PingguSoft/esp32_s3_openfire/stl/button_plate.stl

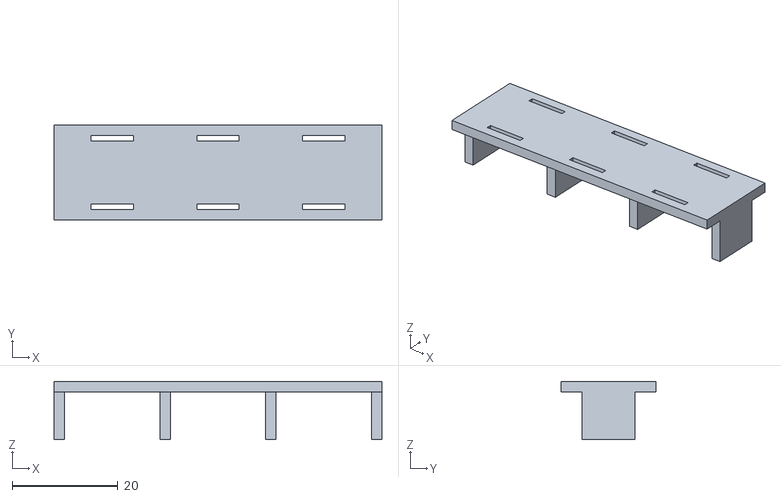
[picture p3: CAD file, 2024-09-30]
stl/button_plate.stl
62.0 x 18.0 x 11.0
