PingguSoft/esp32_s3_openfire/stl/pspjoystick_plate.3mf

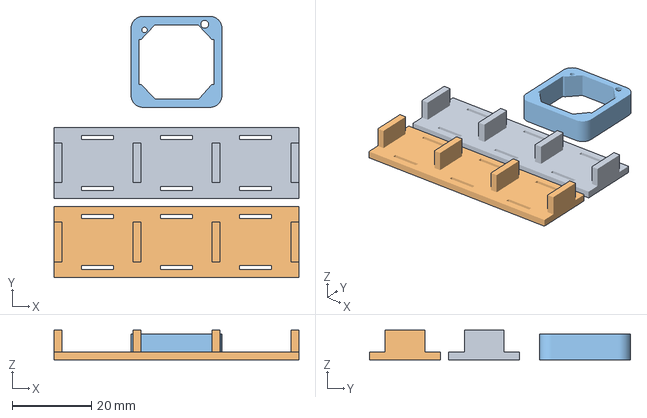
[picture p4: CAD file, 2024-09-30]
stl/pspjoystick_plate.3mf
62.0 x 66.1 x 7.50 mm
button_plate.stl x 2
pspjoystick_plate.stl
