PingguSoft/esp32_s3_openfire/stl/trigger_switch_board.stl

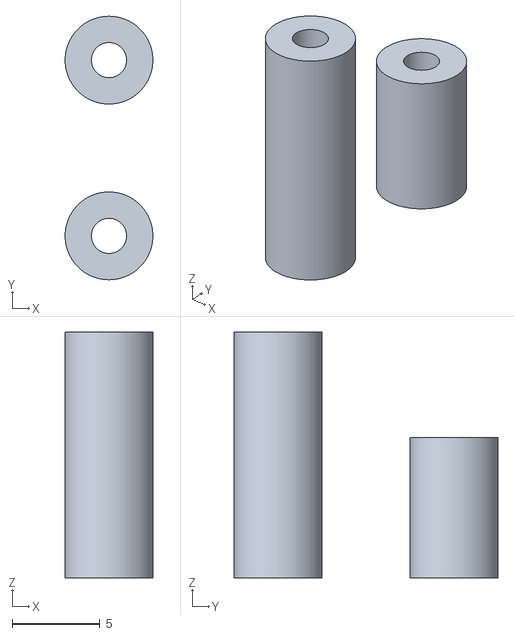
[picture p5: CAD file, 2024-08-26]
stl/trigger_switch_board.stl
5.00 x 15.0 x 14.0
