PingguSoft/esp32_s3_openfire/stl/pwr_board.stl

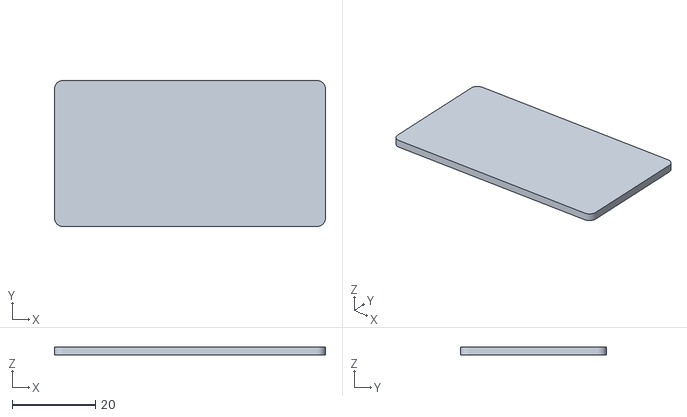
[picture p6: CAD file, 2024-08-26]
stl/pwr_board.stl
65.0 x 35.0 x 2.00
