PingguSoft/esp32_s3_openfire/stl/recoil_relay_adapter.stl

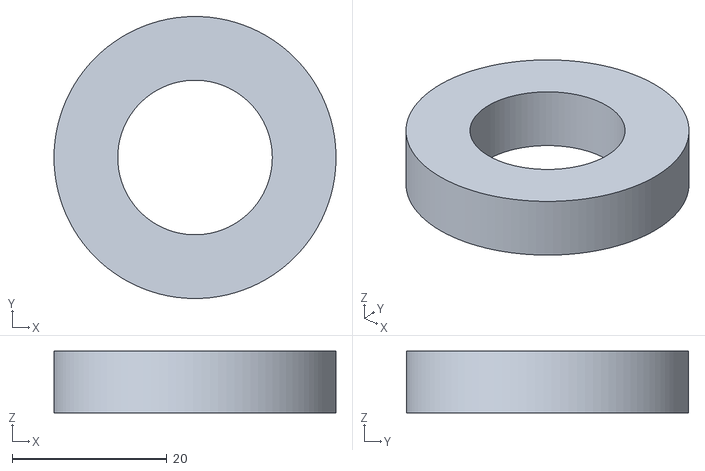
[picture p7: CAD file, 2024-08-21]
stl/recoil_relay_adapter.stl
36.5 x 36.5 x 8.00
