PingguSoft/esp32_s3_openfire/stl/lens_holder.stl

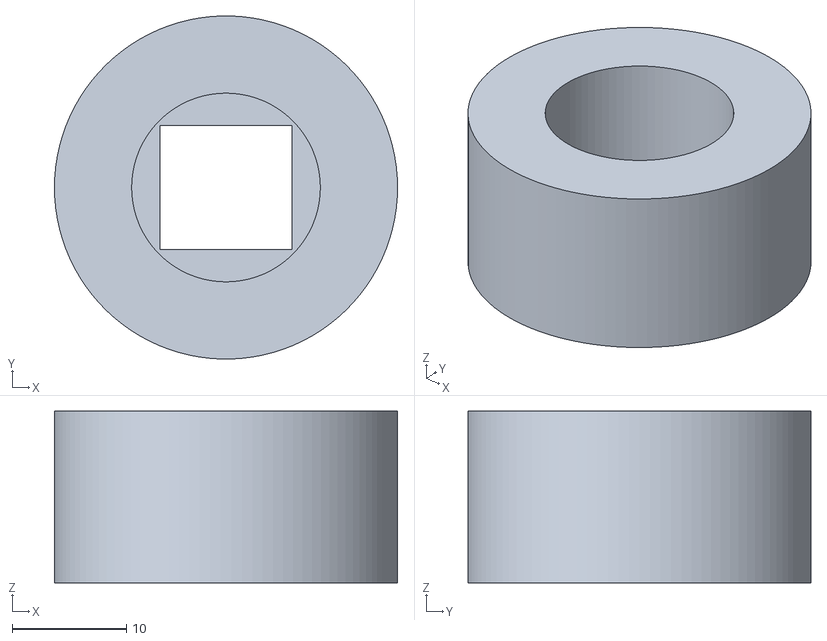
[picture p8: CAD file, 2024-08-21]
stl/lens_holder.stl
30.0 x 30.0 x 15.0
