PingguSoft/esp32_s3_openfire/(list of files, cad)

Other CAD files:
stl/pspjoystick_plate.stl
