PingguSoft/esp32_s3_openfire/docs/tool_issues.txt

.platformio\penv\Lib\site-packages\platformio\util.py 수정 for arm64
arm64 package가 대부분 없으므로 amd64용으로 받기위함

def get_systype():
    system = platform.system().lower()
    arch = platform.machine().lower()
    if system == "windows":
        if not arch:  # issue #4353
            arch = "x86_" + platform.architecture()[0]
        if "x86" in arch:
            arch = "amd64" if "64" in arch else "x86"
        if "arm64" in arch:
            arch = "amd64"

    if arch == "aarch64" and platform.architecture()[0] == "32bit":
        arch = "armv7l"
    return "%s_%s" % (system, arch) if arch else system

esp32s3 usb down 로드 후 reset 안되는 문제

C:\Users\krperf\.platformio\packages\tool-esptoolpy\esptool\targets\esp32s3.py
    def hard_reset(self):
        uses_usb_otg = self.uses_usb_otg()
        if uses_usb_otg:
            self._check_if_can_reset()

        try:
            # Clear force download boot mode to avoid the chip being stuck in download mode after reset
            # workaround for issue: https://github.com/espressif/arduino-esp32/issues/6762
            self.write_reg(
                self.RTC_CNTL_OPTION1_REG, 0, self.RTC_CNTL_FORCE_DOWNLOAD_BOOT_MASK
            )
        except Exception:
            # Skip if response was not valid and proceed to reset; e.g. when monitoring while resetting
            pass

        print("Hard resetting via RTS pin...")
        HardReset(self._port, uses_usb_otg)()

reset !!!
pio run -t reset_target --upload-port COM4
