PingguSoft/esp32_s3_openfire/codes/src/SamcoDisplay.h

/*!
 * @file SamcoDisplay.h
 * @brief Macros for lightgun HUD display.
 *
 * @copyright That One Seong, 2024
 *
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
 *  You should have received a copy of the GNU General Public License
 *  along with this program.  If not, see <https://www.gnu.org/licenses/>.
 */

#ifndef _SAMCODISPLAY_H_
#define _SAMCODISPLAY_H_

#include <stdint.h>

#define SCREEN_WIDTH 128
#define SCREEN_HEIGHT 64

class ExtDisplay {
public:
    /// @brief Constructor
    ExtDisplay();

    /// @brief Attempt to start display using current pin numbers from SamcoPreferences
    /// @return success (true) or fail (false)
    bool Begin();

    /// @brief Update top panel with new info
    /// @return nothing
    void TopPanelUpdate(char textPrefix[7], char textInput[16]);

    /// @brief Clear screen for different gun modes
    /// @return nothing
    void ScreenModeChange(int8_t screenMode, bool isAnalog = false);

    /// @brief Perform maintenance operations (WIP)
    /// @details For when values aren't being updated, but still want to change something on the screen
    /// (i.e. small text printouts when health/ammo empty)
    /// @return nothing
    void IdleOps();

    /// @brief Draw seen points here
    /// @details Should ONLY be used in scenarios where the mouse isn't being updated, i.e. calibration.
    /// @return nothing
    void DrawVisibleIR(int pointX[4], int pointY[4]);

    /// @brief Draw hotkey pause mode layout
    /// @return nothing
    void PauseScreenShow(uint8_t currentProf, char name1[16], char name2[16], char name3[16], char name4[16]);

    /// @brief Update simple pause mode list on screen
    /// @return nothing
    void PauseListUpdate(uint8_t selection);

    /// @brief Update simple pause mode profiles list on screen
    /// @return nothing
    void PauseProfileUpdate(uint8_t selection, char name1[16], char name2[16], char name3[16], char name4[16]);

    /// @brief Print save status message
    void SaveScreen(uint8_t status);

    /// @brief Update main screen ammo glyphs
    /// @return nothing
    void PrintAmmo(uint8_t ammo);

    /// @brief Update main screen life glyphs
    /// @return nothing
    void PrintLife(uint8_t life);

    enum ScreenMode_e {
        Screen_None = -1,
        Screen_Init = 0,
        Screen_Normal,
        Screen_Pause,
        Screen_Profile,
        Screen_Saving,
        Screen_SaveSuccess,
        Screen_SaveError,
        Screen_Calibrating,
        Screen_IRTest,
        Screen_Docked,
        Screen_Mamehook_Single,
        Screen_Mamehook_Dual
    };

    enum ScreenPauseList_e {
        ScreenPause_Calibrate = 0,
        ScreenPause_ProfileSelect,
        ScreenPause_Save,
        ScreenPause_Rumble,
        ScreenPause_Solenoid,
        ScreenPause_EscapeKey
    };

    enum ScreenSerialInit_e {
        ScreenSerial_None = 0,
        ScreenSerial_Life,
        ScreenSerial_Ammo,
        ScreenSerial_Both
    };

    /// @brief Whether life updates are in lifebar or life glyphs form
    bool lifeBar = false;

    /// @brief Which layout we use for serial mode
    uint8_t serialDisplayType = 0;

private:
    bool displayValid = false;

    int8_t screenState = Screen_None;

    bool ammoEmpty = false;
    bool lifeEmpty = false;

    uint8_t currentAmmo;
    uint8_t currentLife;

    // timestamps, in case we need them for periodic tasks in IdleOps()
    unsigned long ammoTimestamp = 0;
    unsigned long lifeTimestamp = 0;
    unsigned long idleTimeStamp = 0;


    #define NUMBER_GLYPH_WIDTH 21
    #define NUMBER_GLYPH_HEIGHT 36
    /// @brief Glyphs for common HUD elements
    static constexpr uint8_t number_0[] = {
        0x1f, 0xff, 0xc0, 0x3f, 0xff, 0xe0, 0x5f, 0xff, 0xd0, 0xe0, 0x00, 0x78, 0xe0, 0x00, 0xf8, 0xe0,
        0x00, 0xf8, 0xe0, 0x01, 0xb8, 0xe0, 0x01, 0xb8, 0xe0, 0x03, 0x38, 0xe0, 0x03, 0x38, 0xe0, 0x06,
        0x38, 0xe0, 0x06, 0x38, 0xe0, 0x0c, 0x38, 0xe0, 0x0c, 0x38, 0xe0, 0x18, 0x38, 0xe0, 0x18, 0x38,
        0xef, 0xff, 0xb8, 0x5f, 0xff, 0xd0, 0xef, 0xff, 0xb8, 0xe0, 0x60, 0x38, 0xe0, 0x60, 0x38, 0xe0,
        0xc0, 0x38, 0xe0, 0xc0, 0x38, 0xe1, 0x80, 0x38, 0xe1, 0x80, 0x38, 0xe3, 0x00, 0x38, 0xe3, 0x00,
        0x38, 0xe6, 0x00, 0x38, 0xe6, 0x00, 0x38, 0xec, 0x00, 0x38, 0xec, 0x00, 0x38, 0xf8, 0x00, 0x38,
        0xf8, 0x00, 0x38, 0x5f, 0xff, 0xd0, 0x3f, 0xff, 0xe0, 0x1f, 0xff, 0xc0
    };

    static constexpr uint8_t number_1[] = {
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
        0x00, 0x00, 0x00, 0x00, 0x0f, 0xf0, 0x00, 0x00, 0x00, 0x00, 0x03, 0xc0, 0x00, 0x00, 0x00, 0x00,
        0x03, 0xc0, 0x00, 0x00, 0x00, 0x00, 0x03, 0xc0, 0x00, 0x00, 0x00, 0x00, 0x03, 0xc0, 0x00, 0x00
    };
};

#endif // _SAMCODISPLAY_H_
