PingguSoft/esp32_s3_openfire/(commit log)

2024-08-26 gpio update
    [pwr_board.stl, trigger_switch_board.stl]
2024-08-28 handling switches
2024-08-29 esp32-ble-compositieHID added
2024-08-30 usb and ble devices test
2024-09-03 classes for HID, FFB and Button
2024-09-11 button re-arranging
2024-09-30 add more buttons
    [button_plate.stl, pspjoystick_plate.3mf, pspjoystick_plate.stl]
2024-09-30 adc handling
2024-10-15 GunMenu Display bug fix
    [GunDisplay.cpp, GunDisplay.h, GunSettings.h, main.cpp]
2024-10-17 analog stick button emulation support
